adafruit/Adafruit-Grand-Central-PCB/Adafruit Grand Central M4 Express rev B.sch

## EAGLE design Adafruit Grand Central M4 Express rev B.sch (2019-01-11)

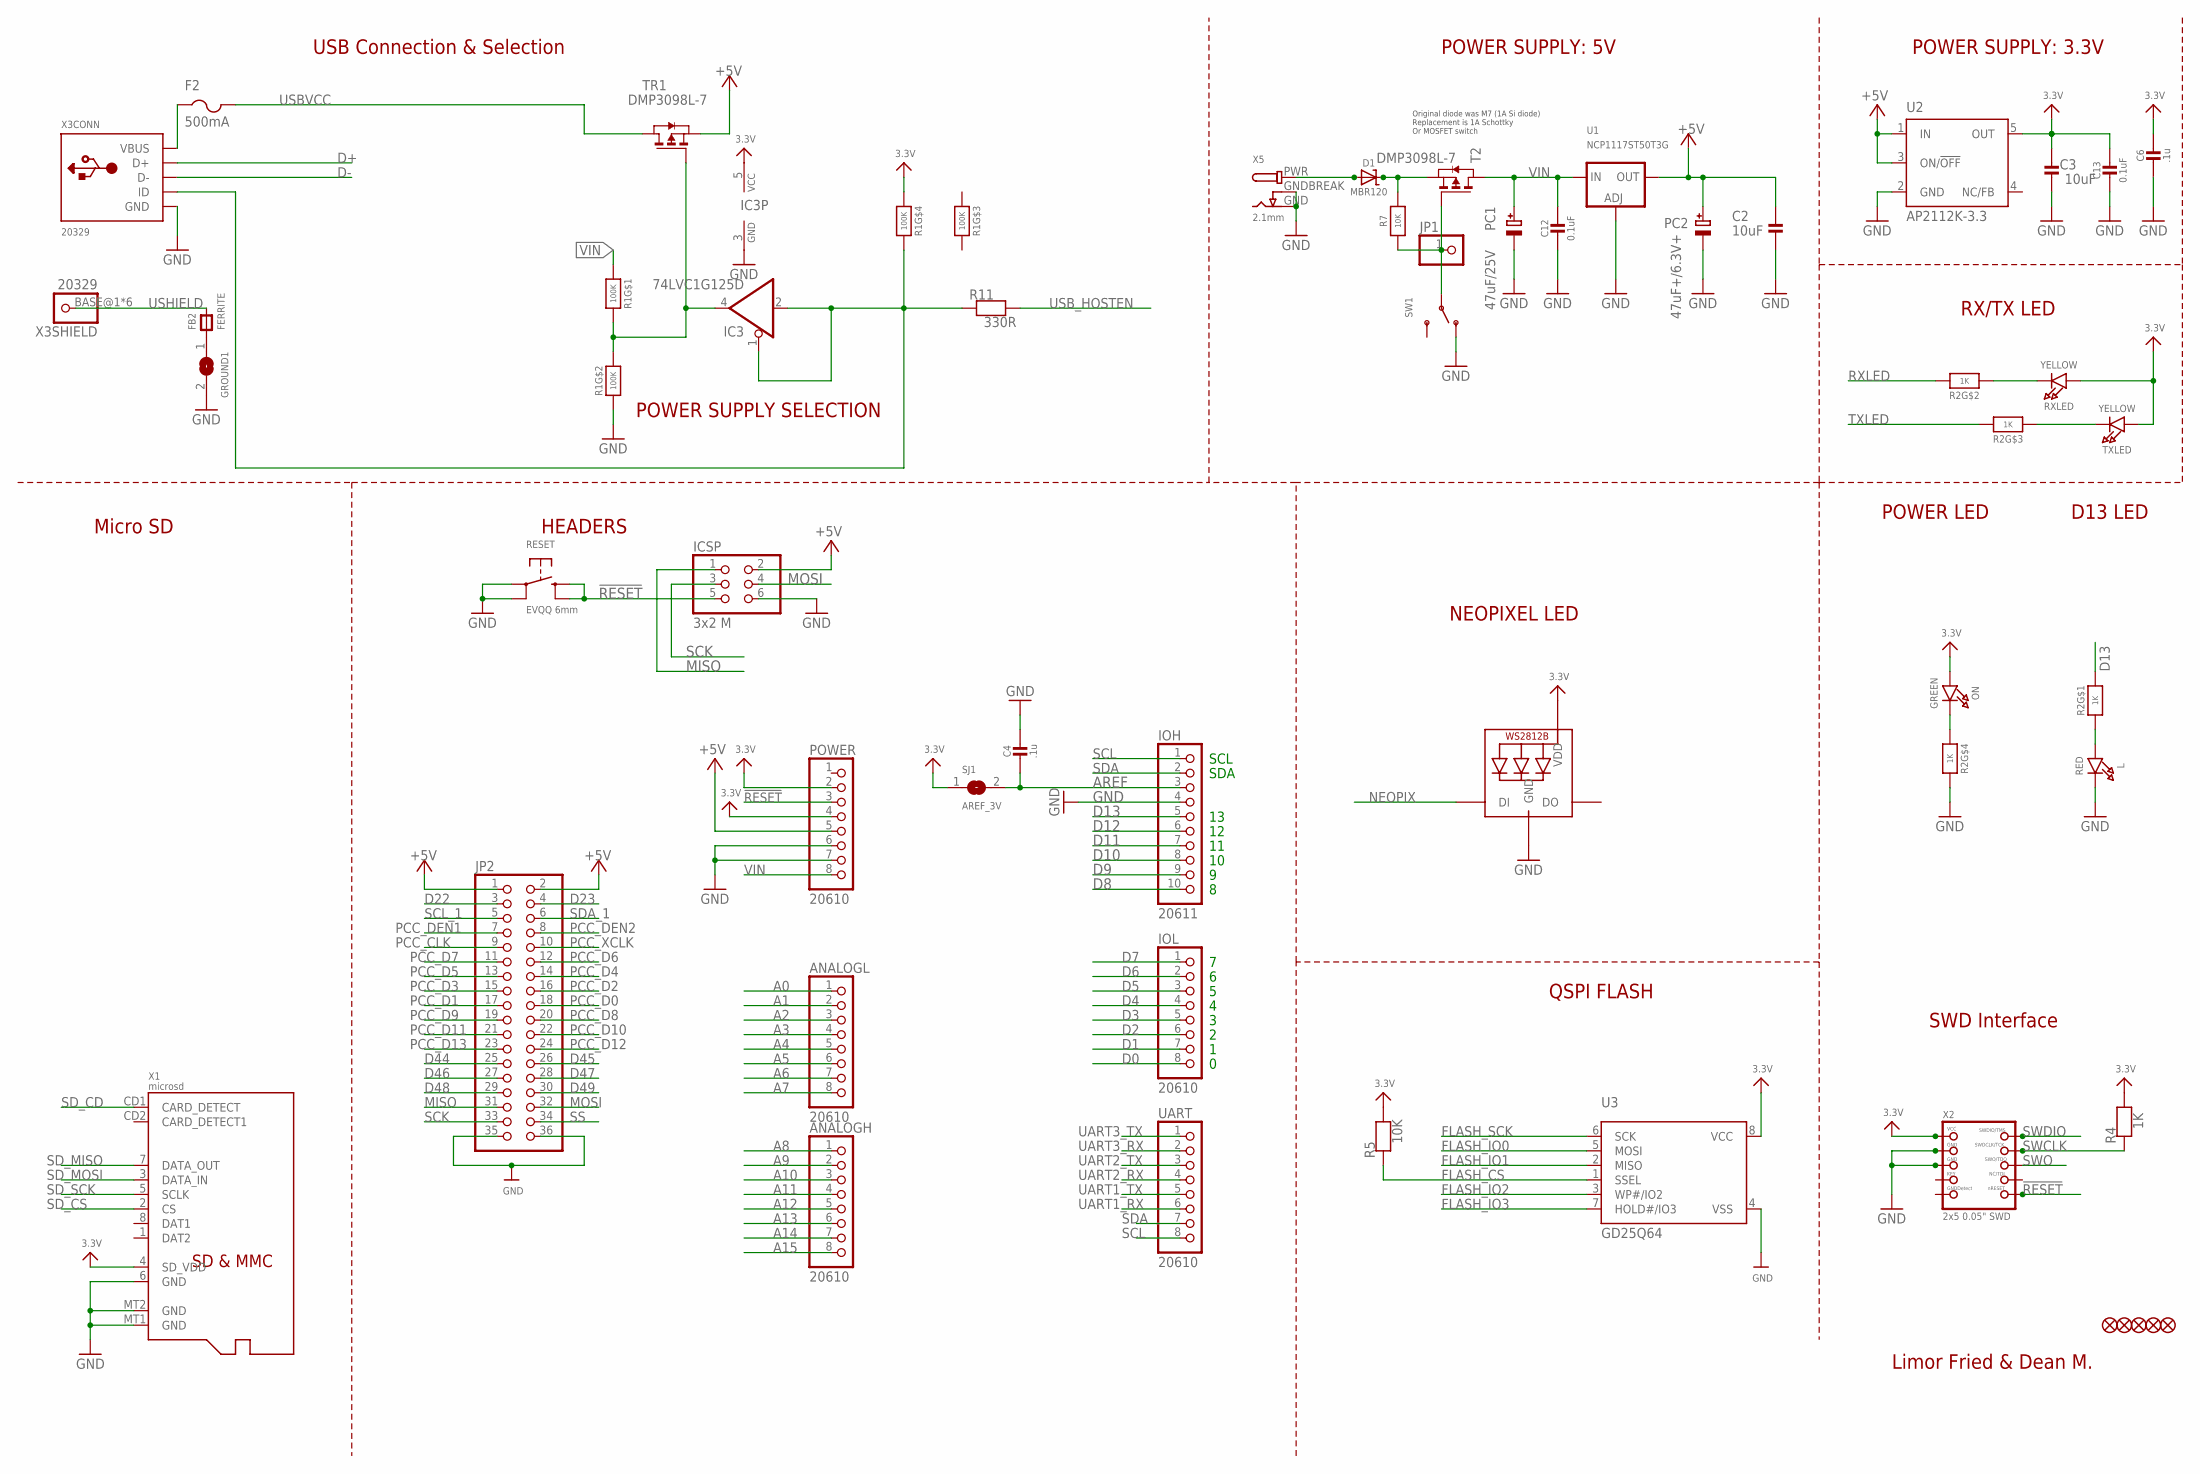
[picture p2: schematic Adafruit Grand Central M4 Express rev B.sch, sheet 1]

Parts:
ANALOGH: 20610; 1X08_OVALWAVE
ANALOGL: 20610; 1X08_OVALWAVE
C2, C3: 10uF; 0805-NO
C4, C6: .1u; 0603-NO
C12, C13: 0.1uF; 0603-NO
D1: MBR120; SOD-123
F2: 500mA; R1206
FB2: FERRITE; 0805-NO
FD1, FD2, FD3, FD4, FD5: FIDUCIAL_1MM
GROUND1: SOLDERJUMPERCLOSED; SOLDERJUMPER_CLOSEDWIRE
IC3: 74LVC1G125D; SOT23-5
ICSP: 3x2 M; 2X03_ROUND_70MIL
IOH: 20611; 1X10_OVALWAVE
IOL: 20610; 1X08_OVALWAVE
JP1: HEADER-1X1ROUND; 1X01_ROUND
JP2: PINHD-2X18_THICKWAV; 2X18_THICKWAVE
L: RED; CHIPLED_0805_NOOUTLINE
LED1: WS2812B3535; LED3535
ON: GREEN; CHIPLED_0805_NOOUTLINE
PC1: 47uF/25V; PANASONIC_D
PC2: 47uF+/6.3V+; PANASONIC_D
POWER: 20610; 1X08_OVALWAVE
R1: 100K; RESPACK_4X0603
R2: 1K; RESPACK_4X0603
R4: 1K; 0603-NO
R5, R7: 10K; 0603-NO
R11: 330R; 0603-NO
RESET: EVQQ 6mm; EVQ-Q2_SMALLER
RXLED: YELLOW; CHIPLED_0805_NOOUTLINE
SJ1: AREF_3V; SOLDERJUMPER_CLOSEDWIRE
SW1: SWITCH_SPDT; SPDT_SMT_SSSS811101
T2: DMP3098L-7; SOT-23
TR1: DMP3098L-7; SOT-23
TXLED: YELLOW; CHIPLED_0805_NOOUTLINE
U1: NCP1117ST50T3G; SOT223-R
U2: AP2112K-3.3; SOT23-DBV
U3: GD25Q64; SOIC8_208MIL
UART: 20610; 1X08_OVALWAVE
X1: microsd; MICROSD
X2: 2x5 0.05" SWD; 2X05_1.27MM_BOX_POSTS
X3: 20329; 4UCONN_20329_V2
X5: 2.1mm; DCJACK_2MM_PTH

Connections:
3.3V: C3.2, C6.2, C13.1, IC3.5 (VCC), LED1.2 (VDD), ON.A, POWER.2, POWER.4, R1.4 (1), R4.2, R5.2, RXLED.A, SJ1.1, TXLED.A, U2.5 (OUT), U3.8 (VCC), X1.4 (SD_VDD), X2.1 (VCC)
!RESET: ICSP.5, POWER.3, RESET.B (S), RESET.B' (S1), X2.10 (NRESET)
+5V: C2.2, ICSP.2, JP2.1, JP2.2, PC2.+, POWER.5, TR1.2 (S), U1.2 (OUT), U2.1 (IN), U2.3 (ON/!OFF)
A0: ANALOGL.1
A1: ANALOGL.2
A2: ANALOGL.3
A3: ANALOGL.4
A4: ANALOGL.5
A5: ANALOGL.6
A6: ANALOGL.7
A7: ANALOGL.8
A8: ANALOGH.1
A9: ANALOGH.2
A10: ANALOGH.3
A11: ANALOGH.4
A12: ANALOGH.5
A13: ANALOGH.6
A14: ANALOGH.7
A15: ANALOGH.8
AREF: C4.1, IOH.3, SJ1.2
D0: IOL.8
D1: IOL.7
D2: IOL.6
D3: IOL.5
D4: IOL.4
D5: IOL.3
D6: IOL.2
D7: IOL.1
D8: IOH.10
D9: IOH.9
D10: IOH.8
D11: IOH.7
D12: IOH.6
D13: IOH.5, R2.8 (2)
D22: JP2.3
D23: JP2.4
D44: JP2.25
D45: JP2.26
D46: JP2.27
D47: JP2.28
D48: JP2.29
D49: JP2.30
D+: X3.D+
D-: X3.D-
FLASH_CS: R5.1, U3.1 (SSEL)
FLASH_IO0: U3.5 (MOSI)
FLASH_IO1: U3.2 (MISO)
FLASH_IO2: U3.3 (WP#/IO2)
FLASH_IO3: U3.7 (HOLD#/IO3)
FLASH_SCK: U3.6 (SCK)
GND: C2.1, C3.1, C4.2, C6.1, C12.2, C13.2, GROUND1.2, IC3.3 (GND), ICSP.6, IOH.4, JP2.35, JP2.36, L.C, LED1.4 (GND), PC1.-, PC2.-, POWER.6, POWER.7, R1.2 (1), R2.5 (2), RESET.A, RESET.A' (P1), SW1.A (O), U1.1 (ADJ), U2.2 (GND), U3.4 (VSS), X1.6 (GND), X1.MT1 (GND), X1.MT2 (GND), X2.3 (GND), X2.5 (GND), X3.GND, X5.GND, X5.GNDBREAK
MISO: ICSP.1, JP2.31
MOSI: ICSP.4, JP2.32
unnamed: L.A, R2.1
unnamed: FB2.1, GROUND1.1
unnamed: ON.C, R2.4 (1)
unnamed: R2.2 (1), RXLED.C
unnamed: R2.3 (1), TXLED.C
unnamed: IC3.1 (OE), IC3.2 (I), R1.5 (2), R11.1, X3.ID
unnamed: IC3.4 (O), R1.7 (2), R1.8 (2), TR1.3 (G)
unnamed: D1.C, R7.2, T2.2 (S)
NEOPIX: LED1.1 (DI)
PCC_CLK: JP2.9
PCC_D0: JP2.18
PCC_D1: JP2.17
PCC_D2: JP2.16
PCC_D3: JP2.15
PCC_D4: JP2.14
PCC_D5: JP2.13
PCC_D6: JP2.12
PCC_D7: JP2.11
PCC_D8: JP2.20
PCC_D9: JP2.19
PCC_D10: JP2.22
PCC_D11: JP2.21
PCC_D12: JP2.24
PCC_D13: JP2.23
PCC_DEN1: JP2.7
PCC_DEN2: JP2.8
PCC_XCLK: JP2.10
PWRIN: D1.A, X5.PWR
PWR_SWITCH: JP1.1, R7.1, SW1.B, T2.3 (G)
RXLED: R2.7 (2)
SCK: ICSP.3, JP2.33
SCL: IOH.1, UART.8
SCL_1: JP2.5
SDA: IOH.2, UART.7
SDA_1: JP2.6
SD_CD: X1.CD1 (CARD_DETECT)
SD_CS: X1.2 (CS)
SD_MISO: X1.7 (DATA_OUT)
SD_MOSI: X1.3 (DATA_IN)
SD_SCK: X1.5 (SCLK)
SS: JP2.34
SWCLK: R4.1, X2.4 (SWDCLK)
SWDIO: X2.2 (SWDIO)
SWO: X2.6 (SWO)
TXLED: R2.6 (2)
UART1_RX: UART.6
UART1_TX: UART.5
UART2_RX: UART.4
UART2_TX: UART.3
UART3_RX: UART.2
UART3_TX: UART.1
USBVCC: F2.2, TR1.1 (D)
USB_HOSTEN: R11.2
USHIELD: FB2.2, X3.BASE@1 (1)
VBUS: F2.1, X3.VBUS
VIN: C12.1, PC1.+, POWER.8, R1.1, T2.1 (D), U1.3 (IN)

Notes on the sheet:
SDA
SCL
Limor Fried & Dean M.
Original diode was M7 (1A Si diode) Replacement is 1A Schottky Or MOSFET switch
POWER SUPPLY: 5V
USB Connection & Selection
POWER SUPPLY: 3.3V
POWER LED
HEADERS
POWER SUPPLY SELECTION
D13 LED
RX/TX LED
NEOPIXEL LED
QSPI FLASH
SWD Interface
Micro SD

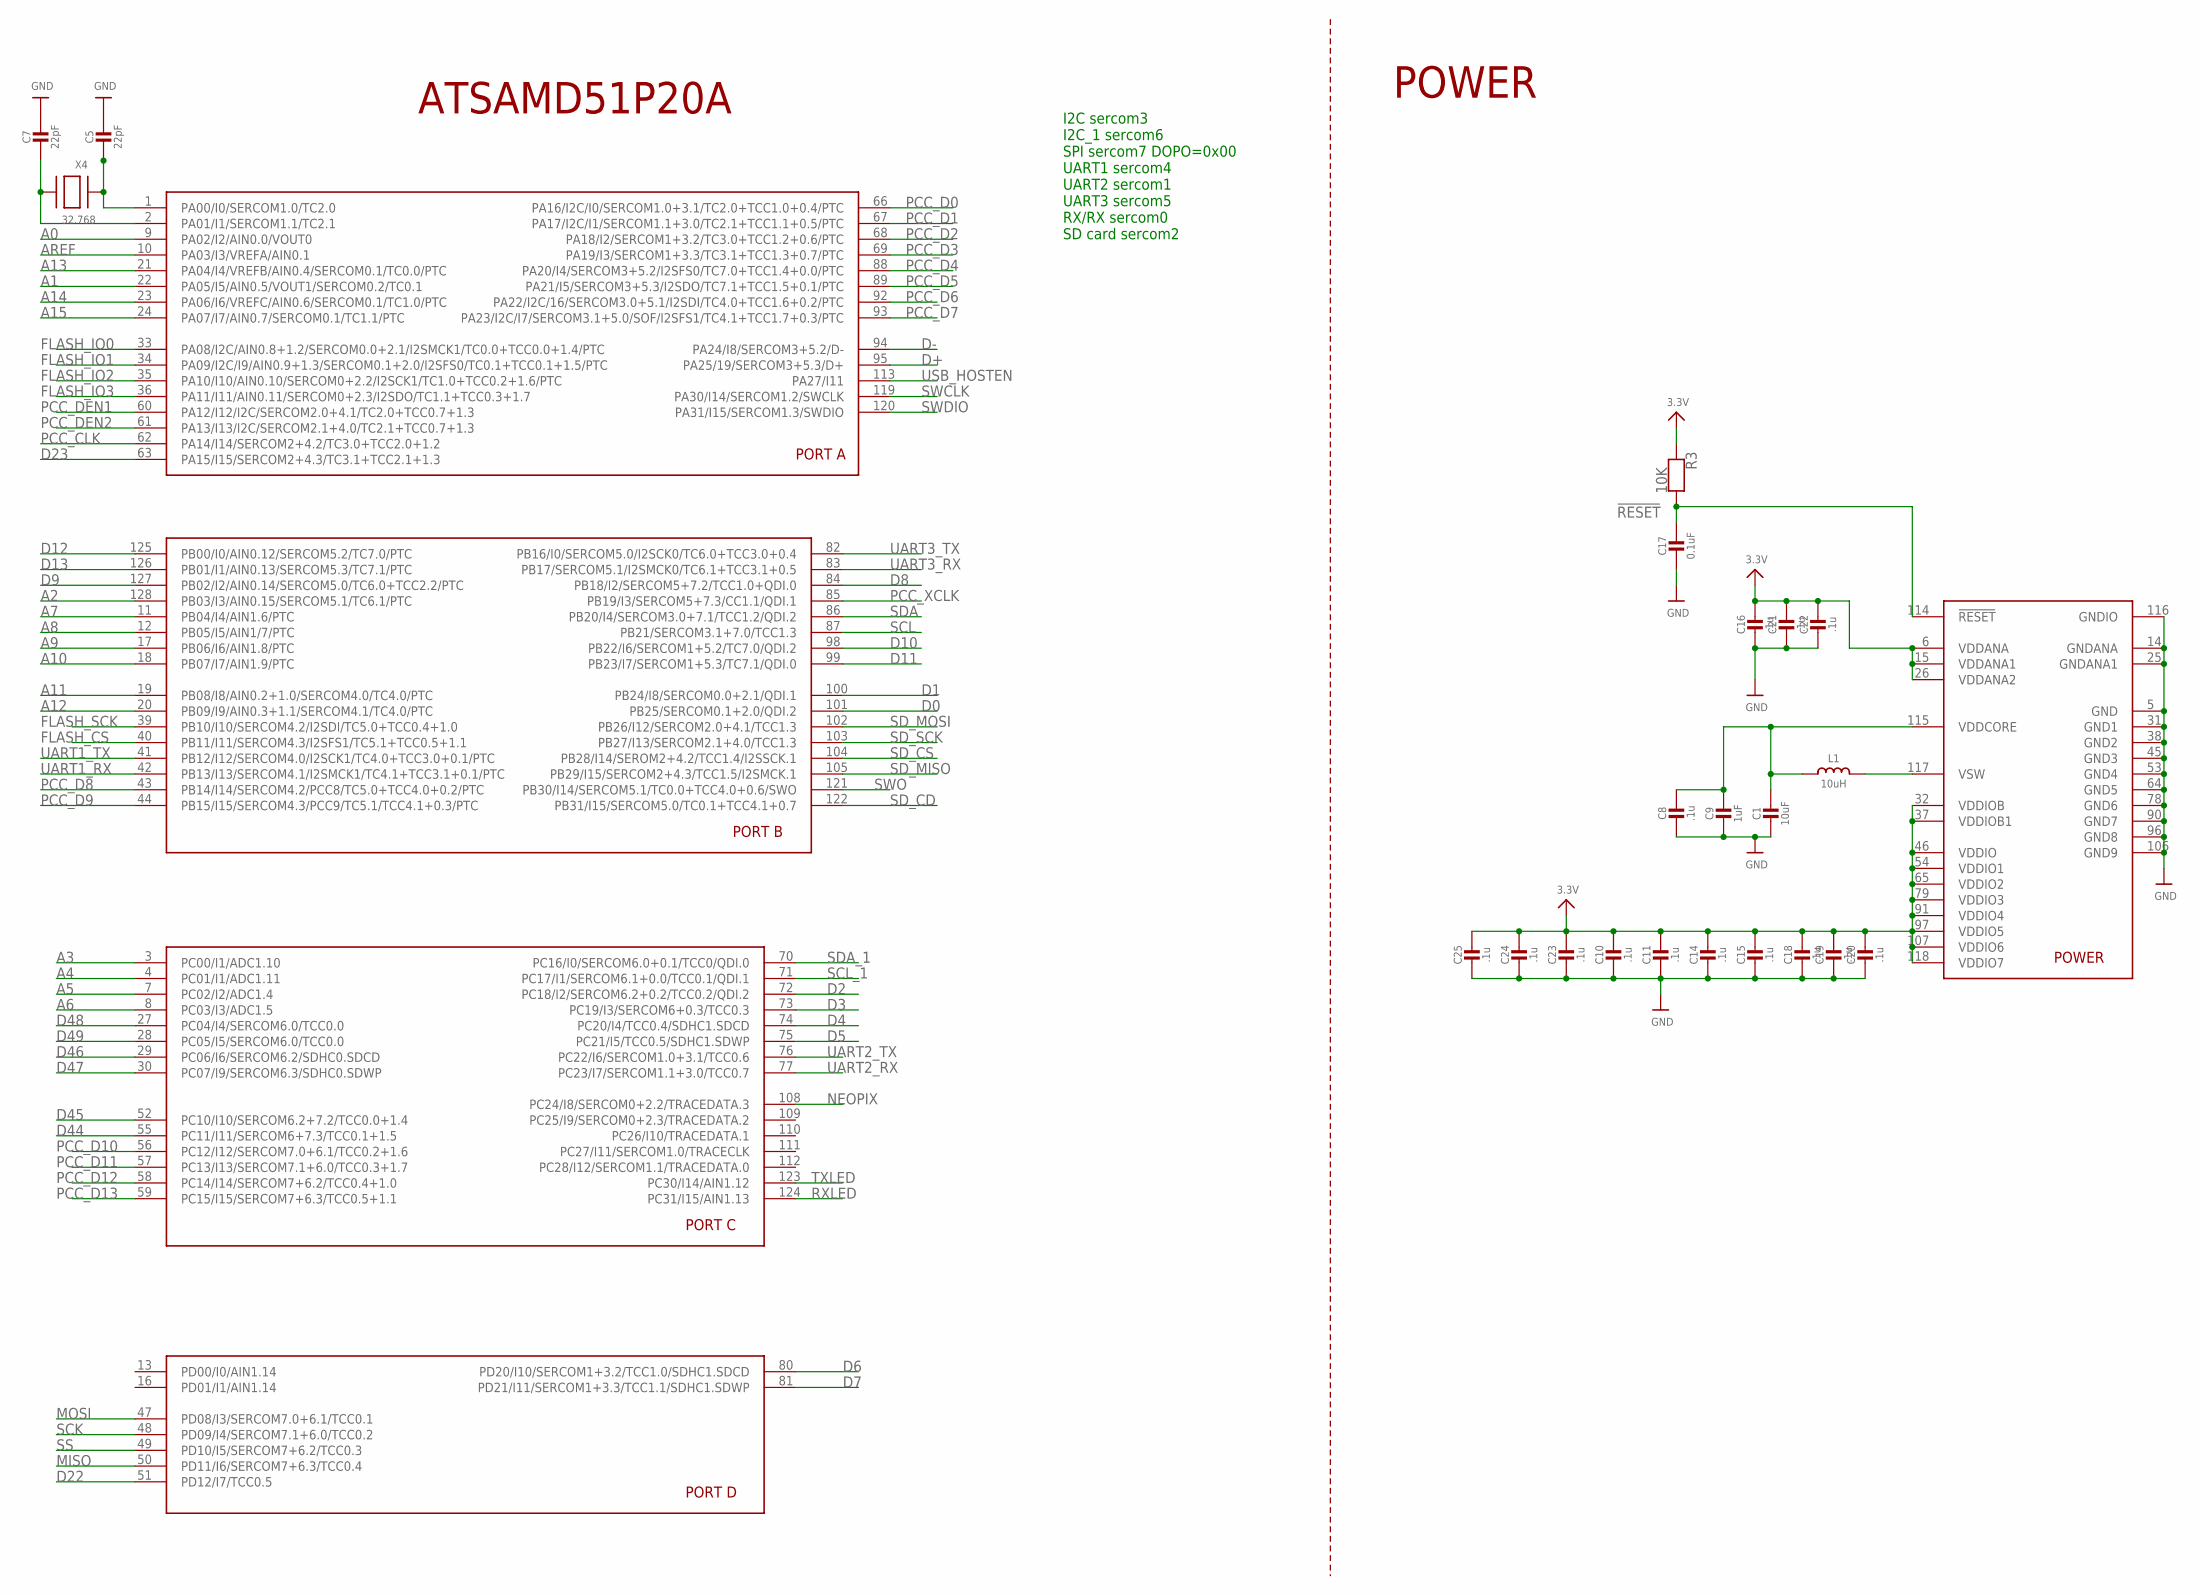
[picture p3: schematic Adafruit Grand Central M4 Express rev B.sch, sheet 2]

Parts:
C1: 10uF; 0805-NO
C5, C7: 22pF; 0603-NO
C8, C10, C11, C14, C15, C16, C18, C19, C20, C21, C22, C23, C24, C25: .1u; 0603-NO
C9: 1uF; 0603-NO
C17: 0.1uF; 0603-NO
L1: 10uH; INDUCTOR_1007
R3: 10K; 0603-NO
U$1: SAMD51PXXA; SQFP-S-14X14-128
X4: 32.768; XTAL3215

Connections:
3.3V: C10.2, C11.2, C14.2, C15.2, C16.2, C18.2, C19.2, C20.2, C21.2, C22.2, C23.2, C24.2, C25.2, R3.1, U$1.6 (VDDANA), U$1.15 (VDDANA1), U$1.26 (VDDANA2), U$1.32 (VDDIOB), U$1.37 (VDDIOB1), U$1.46 (VDDIO), U$1.54 (VDDIO1), U$1.65 (VDDIO2), U$1.79 (VDDIO3), U$1.91 (VDDIO4), U$1.97 (VDDIO5), U$1.107 (VDDIO6), U$1.118 (VDDIO7)
!RESET: C17.2, R3.2, U$1.114 (!RESET)
A0: U$1.9 (PA02/I2/AIN0.0/VOUT0)
A1: U$1.22 (PA05/I5/AIN0.5/VOUT1/SERCOM0.2/TC0.1)
A2: U$1.128 (PB03/I3/AIN0.15/SERCOM5.1/TC6.1/PTC)
A3: U$1.3 (PC00/I1/ADC1.10)
A4: U$1.4 (PC01/I1/ADC1.11)
A5: U$1.7 (PC02/I2/ADC1.4)
A6: U$1.8 (PC03/I3/ADC1.5)
A7: U$1.11 (PB04/I4/AIN1.6/PTC)
A8: U$1.12 (PB05/I5/AIN1/7/PTC)
A9: U$1.17 (PB06/I6/AIN1.8/PTC)
A10: U$1.18 (PB07/I7/AIN1.9/PTC)
A11: U$1.19 (PB08/I8/AIN0.2+1.0/SERCOM4.0/TC4.0/PTC)
A12: U$1.20 (PB09/I9/AIN0.3+1.1/SERCOM4.1/TC4.0/PTC)
A13: U$1.21 (PA04/I4/VREFB/AIN0.4/SERCOM0.1/TC0.0/PTC)
A14: U$1.23 (PA06/I6/VREFC/AIN0.6/SERCOM0.1/TC1.0/PTC)
A15: U$1.24 (PA07/I7/AIN0.7/SERCOM0.1/TC1.1/PTC)
AREF: U$1.10 (PA03/I3/VREFA/AIN0.1)
D0: U$1.101 (PB25/SERCOM0.1+2.0/QDI.2)
D1: U$1.100 (PB24/I8/SERCOM0.0+2.1/QDI.1)
D2: U$1.72 (PC18/I2/SERCOM6.2+0.2/TCC0.2/QDI.2)
D3: U$1.73 (PC19/I3/SERCOM6+0.3/TCC0.3)
D4: U$1.74 (PC20/I4/TCC0.4/SDHC1.SDCD)
D5: U$1.75 (PC21/I5/TCC0.5/SDHC1.SDWP)
D6: U$1.80 (PD20/I10/SERCOM1+3.2/TCC1.0/SDHC1.SDCD)
D7: U$1.81 (PD21/I11/SERCOM1+3.3/TCC1.1/SDHC1.SDWP)
D8: U$1.84 (PB18/I2/SERCOM5+7.2/TCC1.0+QDI.0)
D9: U$1.127 (PB02/I2/AIN0.14/SERCOM5.0/TC6.0+TCC2.2/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)
D10: U$1.98 (PB22/I6/SERCOM1+5.2/TC7.0/QDI.2)
D11: U$1.99 (PB23/I7/SERCOM1+5.3/TC7.1/QDI.0)
D12: U$1.125 (PB00/I0/AIN0.12/SERCOM5.2/TC7.0/PTC)
D13: U$1.126 (PB01/I1/AIN0.13/SERCOM5.3/TC7.1/PTC)
D22: U$1.51 (PD12/I7/TCC0.5)
D23: U$1.63 (PA15/I15/SERCOM2+4.3/TC3.1+TCC2.1+1.3)
D44: U$1.55 (PC11/I11/SERCOM6+7.3/TCC0.1+1.5)
D45: U$1.52 (PC10/I10/SERCOM6.2+7.2/TCC0.0+1.4)
D46: U$1.29 (PC06/I6/SERCOM6.2/SDHC0.SDCD)
D47: U$1.30 (PC07/I9/SERCOM6.3/SDHC0.SDWP)
D48: U$1.27 (PC04/I4/SERCOM6.0/TCC0.0)
D49: U$1.28 (PC05/I5/SERCOM6.0/TCC0.0)
D+: U$1.95 (PA25/19/SERCOM3+5.3/D+)
D-: U$1.94 (PA24/I8/SERCOM3+5.2/D-)
FLASH_CS: U$1.40 (PB11/I11/SERCOM4.3/I2SFS1/TC5.1+TCC0.5+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)
FLASH_IO0: U$1.33 (PA08/I2C/AIN0.8+1.2/SERCOM0.0+2.1/I2SMC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)
FLASH_IO1: U$1.34 (PA09/I2C/I9/AIN0.9+1.3/SERCOM0.1+2.0/I2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)
FLASH_IO2: U$1.35 (PA10/I10/AIN0.10/SERCOM0+2.2/I2SCK1/TC1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)
FLASH_IO3: U$1.36 (PA11/I11/AIN0.11/SERCOM0+2.3/I2SDO/TC1.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)
FLASH_SCK: U$1.39 (PB10/I10/SERCOM4.2/I2SDI/TC5.0+TCC0.4+1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)
GND: C1.2, C5.2, C7.2, C8.1, C9.2, C10.1, C11.1, C14.1, C15.1, C16.1, C17.1, C18.1, C19.1, C20.1, C21.1, C22.1, C23.1, C24.1, C25.1, U$1.5 (GND), U$1.14 (GNDANA), U$1.25 (GNDANA1), U$1.31 (GND1), U$1.38 (GND2), U$1.45 (GND3), U$1.53 (GND4), U$1.64 (GND5), U$1.78 (GND6), U$1.90 (GND7), U$1.96 (GND8), U$1.106 (GND9), U$1.116 (GNDIO)
MISO: U$1.50 (PD11/I6/SERCOM7+6.3/TCC0.4)
MOSI: U$1.47 (PD08/I3/SERCOM7.0+6.1/TCC0.1)
unnamed: L1.P$2 (2), U$1.117 (VSW)
unnamed: C5.1, U$1.1 (PA00/I0/SERCOM1.0/TC2.0), X4.P$1
unnamed: C7.1, U$1.2 (PA01/I1/SERCOM1.1/TC2.1), X4.P$2
NEOPIX: U$1.108 (PC24/I8/SERCOM0+2.2/TRACEDATA.3)
PCC_CLK: U$1.62 (PA14/I14/SERCOM2+4.2/TC3.0+TCC2.0+1.2)
PCC_D0: U$1.66 (PA16/I2C/I0/SERCOM1.0+3.1/TC2.0+TCC1.0+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)
PCC_D1: U$1.67 (PA17/I2C/I1/SERCOM1.1+3.0/TC2.1+TCC1.1+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)
PCC_D2: U$1.68 (PA18/I2/SERCOM1+3.2/TC3.0+TCC1.2+0.6/PTC)
PCC_D3: U$1.69 (PA19/I3/SERCOM1+3.3/TC3.1+TCC1.3+0.7/PTC)
PCC_D4: U$1.88 (PA20/I4/SERCOM3+5.2/I2SFS0/TC7.0+TCC1.4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)
PCC_D5: U$1.89 (PA21/I5/SERCOM3+5.3/I2SDO/TC7.1+TCC1.5+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)
PCC_D6: U$1.92 (PA22/I2C/16/SERCOM3.0+5.1/I2SDI/TC4.0+T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)
PCC_D7: U$1.93 (PA23/I2C/I7/SERCOM3.1+5.0/SOF/I2SFS1/TC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)
PCC_D8: U$1.43 (PB14/I14/SERCOM4.2/PCC8/TC5.0+TCC4.0+0.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)
PCC_D9: U$1.44 (PB15/I15/SERCOM4.3/PCC9/TC5.1/TCC4.1+0.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)
PCC_D10: U$1.56 (PC12/I12/SERCOM7.0+6.1/TCC0.2+1.6)
PCC_D11: U$1.57 (PC13/I13/SERCOM7.1+6.0/TCC0.3+1.7)
PCC_D12: U$1.58 (PC14/I14/SERCOM7+6.2/TCC0.4+1.0)
PCC_D13: U$1.59 (PC15/I15/SERCOM7+6.3/TCC0.5+1.1)
PCC_DEN1: U$1.60 (PA12/I12/I2C/SERCOM2.0+4.1/TC2.0+TCC0.7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)
PCC_DEN2: U$1.61 (PA13/I13/I2C/SERCOM2.1+4.0/TC2.1+TCC0.7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)
PCC_XCLK: U$1.85 (PB19/I3/SERCOM5+7.3/CC1.1/QDI.1)
RXLED: U$1.124 (PC31/I15/AIN1.13)
SCK: U$1.48 (PD09/I4/SERCOM7.1+6.0/TCC0.2)
SCL: U$1.87 (PB21/SERCOM3.1+7.0/TCC1.3)
SCL_1: U$1.71 (PC17/I1/SERCOM6.1+0.0/TCC0.1/QDI.1)
SDA: U$1.86 (PB20/I4/SERCOM3.0+7.1/TCC1.2/QDI.2)
SDA_1: U$1.70 (PC16/I0/SERCOM6.0+0.1/TCC0/QDI.0)
SD_CD: U$1.122 (PB31/I15/SERCOM5.0/TC0.1+TCC4.1+0.7)
SD_CS: U$1.104 (PB28/I14/SEROM2+4.2/TCC1.4/I2SSCK.1)
SD_MISO: U$1.105 (PB29/I15/SERCOM2+4.3/TCC1.5/I2SMCK.1)
SD_MOSI: U$1.102 (PB26/I12/SERCOM2.0+4.1/TCC1.3)
SD_SCK: U$1.103 (PB27/I13/SERCOM2.1+4.0/TCC1.3)
SS: U$1.49 (PD10/I5/SERCOM7+6.2/TCC0.3)
SWCLK: U$1.119 (PA30/I14/SERCOM1.2/SWCLK)
SWDIO: U$1.120 (PA31/I15/SERCOM1.3/SWDIO)
SWO: U$1.121 (PB30/I14/SERCOM5.1/TC0.0+TCC4.0+0.6/SWO)
TXLED: U$1.123 (PC30/I14/AIN1.12)
UART1_RX: U$1.42 (PB13/I13/SERCOM4.1/I2SMCK1/TC4.1+TCC3.1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)
UART1_TX: U$1.41 (PB12/I12/SERCOM4.0/I2SCK1/TC4.0+TCC3.0+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)
UART2_RX: U$1.77 (PC23/I7/SERCOM1.1+3.0/TCC0.7)
UART2_TX: U$1.76 (PC22/I6/SERCOM1.0+3.1/TCC0.6)
UART3_RX: U$1.83 (PB17/SERCOM5.1/I2SMCK0/TC6.1+TCC3.1+0.5)
UART3_TX: U$1.82 (PB16/I0/SERCOM5.0/I2SCK0/TC6.0+TCC3.0+0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)
USB_HOSTEN: U$1.113 (PA27/I11)
VDDCORE: C1.1, C8.2, C9.1, L1.P$1 (1), U$1.115 (VDDCORE)

Notes on the sheet:
I2C sercom3 I2C_1 sercom6 SPI sercom7 DOPO=0x00 UART1 sercom4 UART2 sercom1 UART3 sercom5 RX/RX sercom0 SD card sercom2
POWER
ATSAMD51P20A
