adafruit/Adafruit-Grand-Central-PCB/(threads)

Thread 2 (2022-09-08):

add arduino-like diagram like Metro M4

sl1pkn07, 2022-09-08:
Hi

Metro M4 have a arduino-like diagram https://github.com/adafruit/Adafruit-Metro-M4-Express-PCB/blob/master/Adafruit%20Metro%20M4%20Express%20Pinout.pdf

is possible create one similar for the GrandCentralM4?

greetings

ladyada, 2022-10-02:
https://learn.adafruit.com/assets/115366

Closed 2022-10-02.

Thread 3 (2023-01-14):

Incomplete Schematic

professorwade, 2023-01-14:
Unless I am doing something wrong, it looks like the schematic is incomplete. Is there only one sheet, processor appears to be missing.

caternuson, 2023-01-14:
There are two sheets. Can get images of both here:
https://learn.adafruit.com/adafruit-grand-central/downloads#schematics-3015168

In Eagle, switch between sheets using drop down:

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

professorwade, 2023-01-15:
I apologize, my mistake. Newby error using Fusion 360.

Closed 2023-01-15.
