adafruit/Adafruit-Grand-Central-PCB/(commit log)

2019-01-11 Added brd and sch files.
    [Metro M4 Mega rev B.sch]
2019-01-13 Update filenames.
    [Adafruit Grand Central M4 Express rev B.sch]
2019-07-16 updated to use cookiecutter for pcb repos
2022-09-24 Add prettypins-generated board pinout PDF
